morris6/Modulo-Two_ARINC-429_Converter/Mod2ArincBot.png

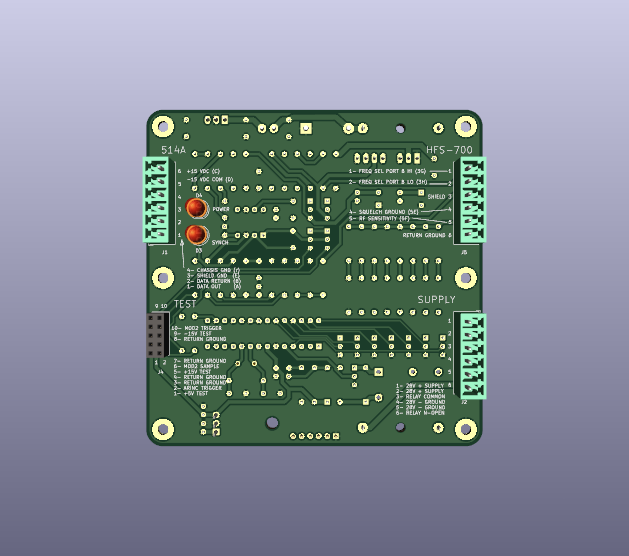
Mod2ArincBot.png
