morris6/Modulo-Two_ARINC-429_Converter/Mod2ArincTop.png

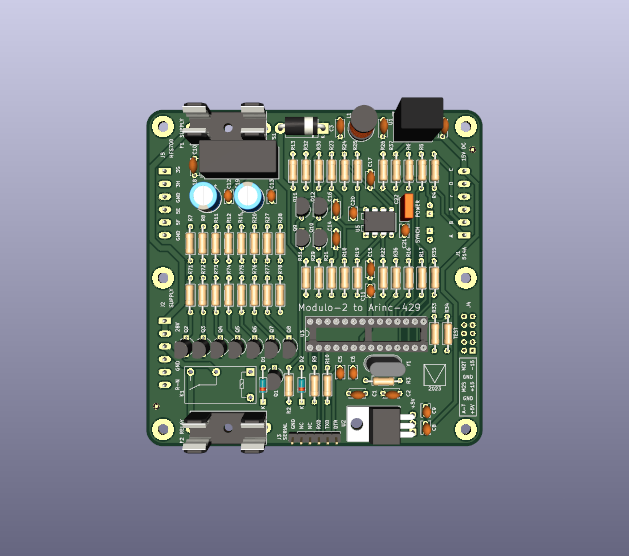
Mod2ArincTop.png
