morris6/Modulo-Two_ARINC-429_Converter/Mod2Boxed.png

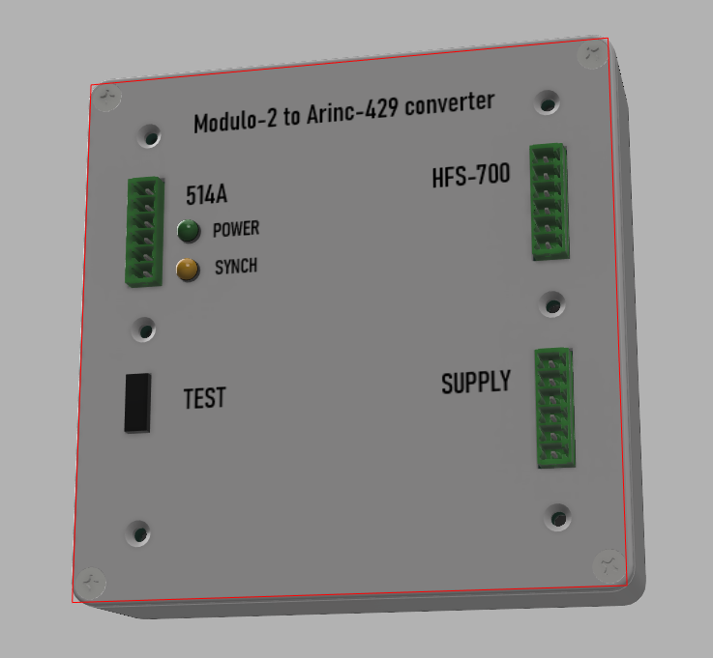
Mod2Boxed.png
