morris6/Modulo-Two_ARINC-429_Converter/(list of files, cad)

Other CAD files:
Mod2ArincProject/1590Q-U-V Lid.f3d
