morris6/Modulo-Two_ARINC-429_Converter/Mod2Arinc.pdf

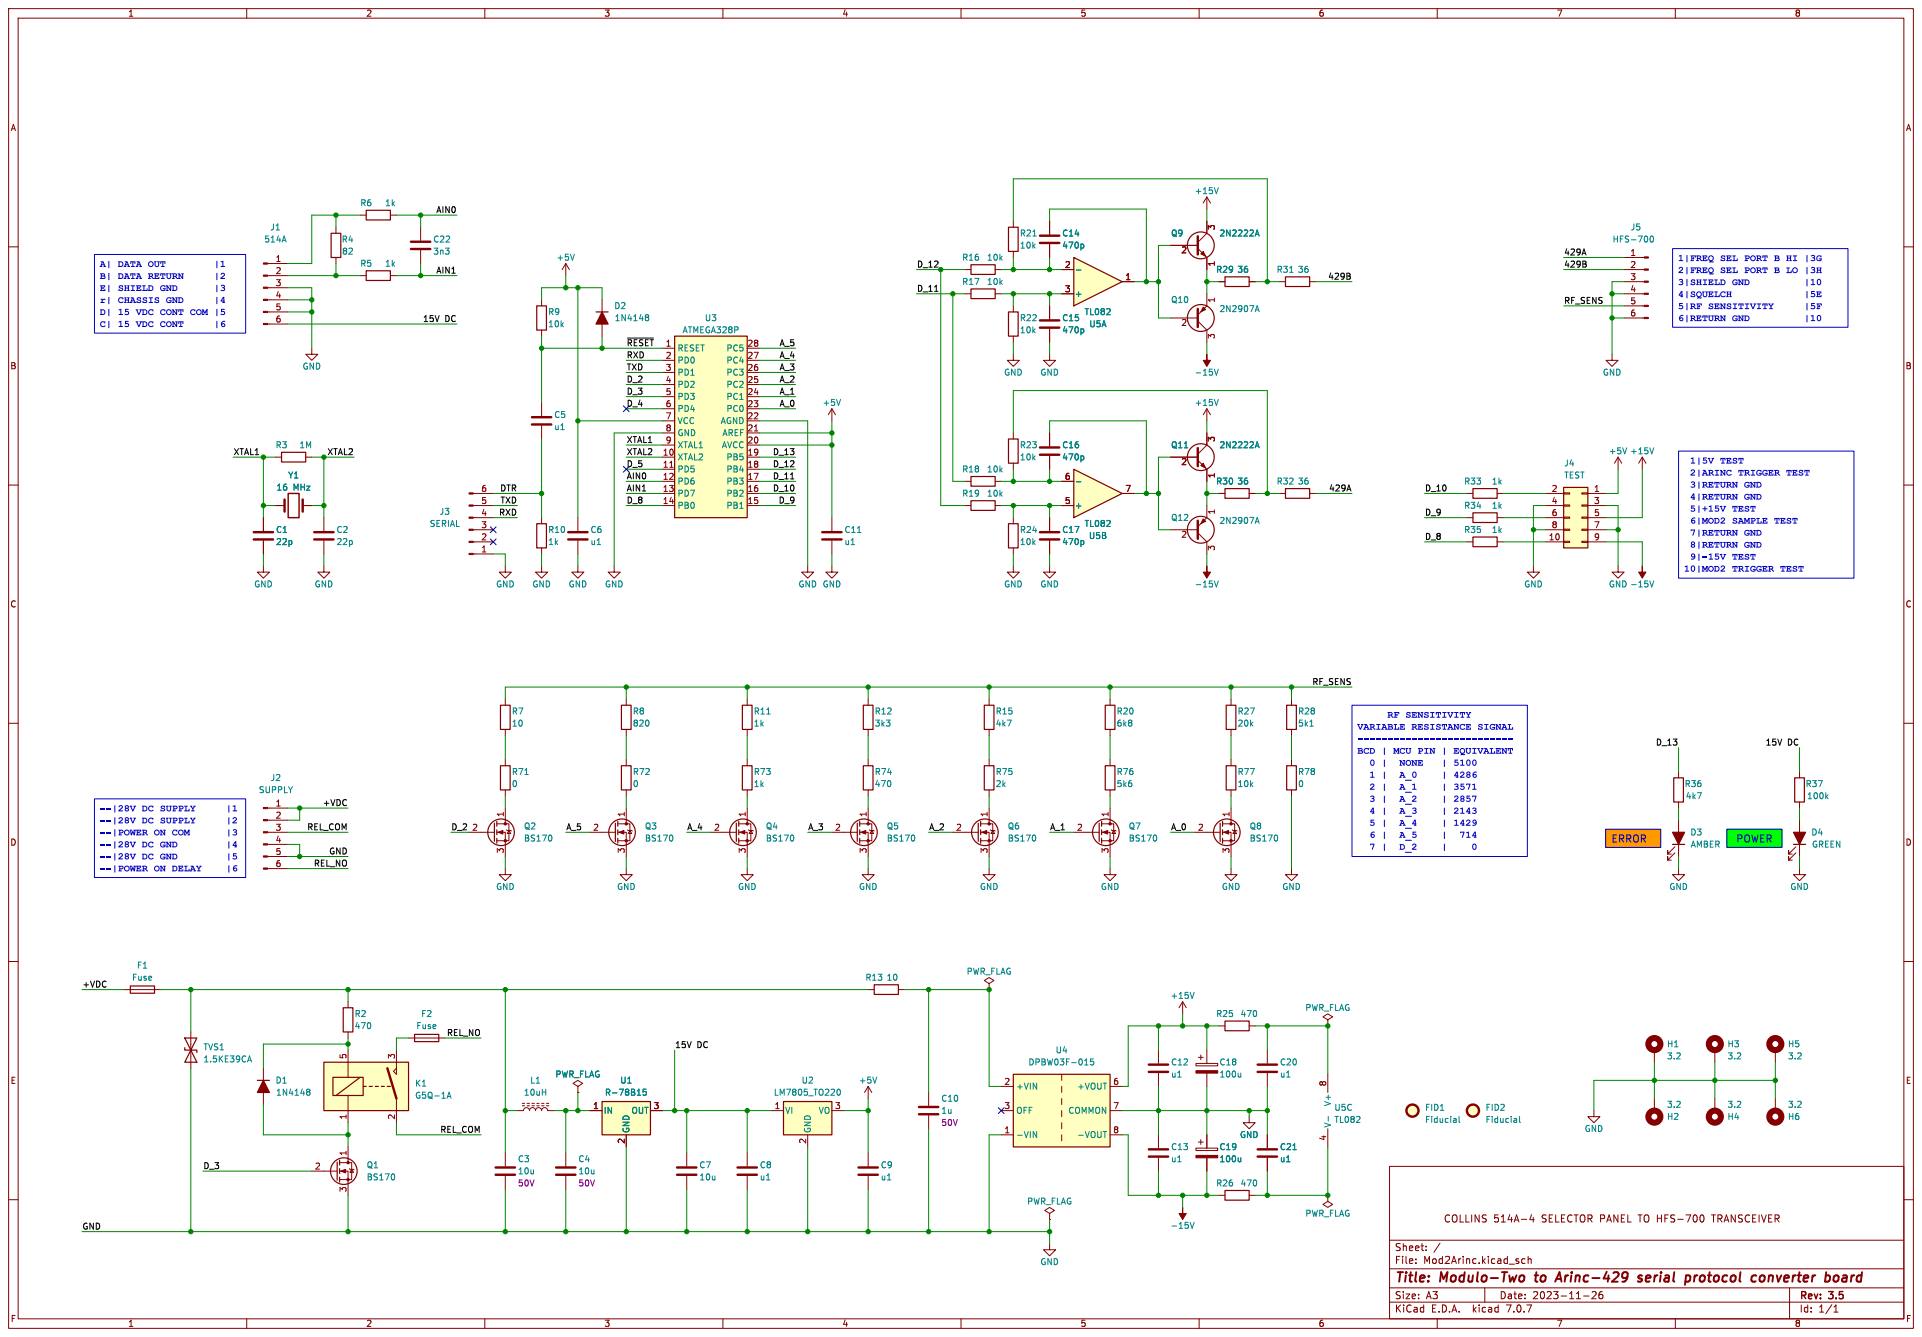
[picture p4: page 1]

1|FREQ SEL PORT B HI |3G
2|FREQ SEL PORT B LO |3H
