morris6/Modulo-Two_ARINC-429_Converter/Mod2ArincProject/Mod2Arinc.kicad_pcb

## KiCad design Mod2ArincProject/Mod2Arinc.kicad_pcb (2023-11-26)

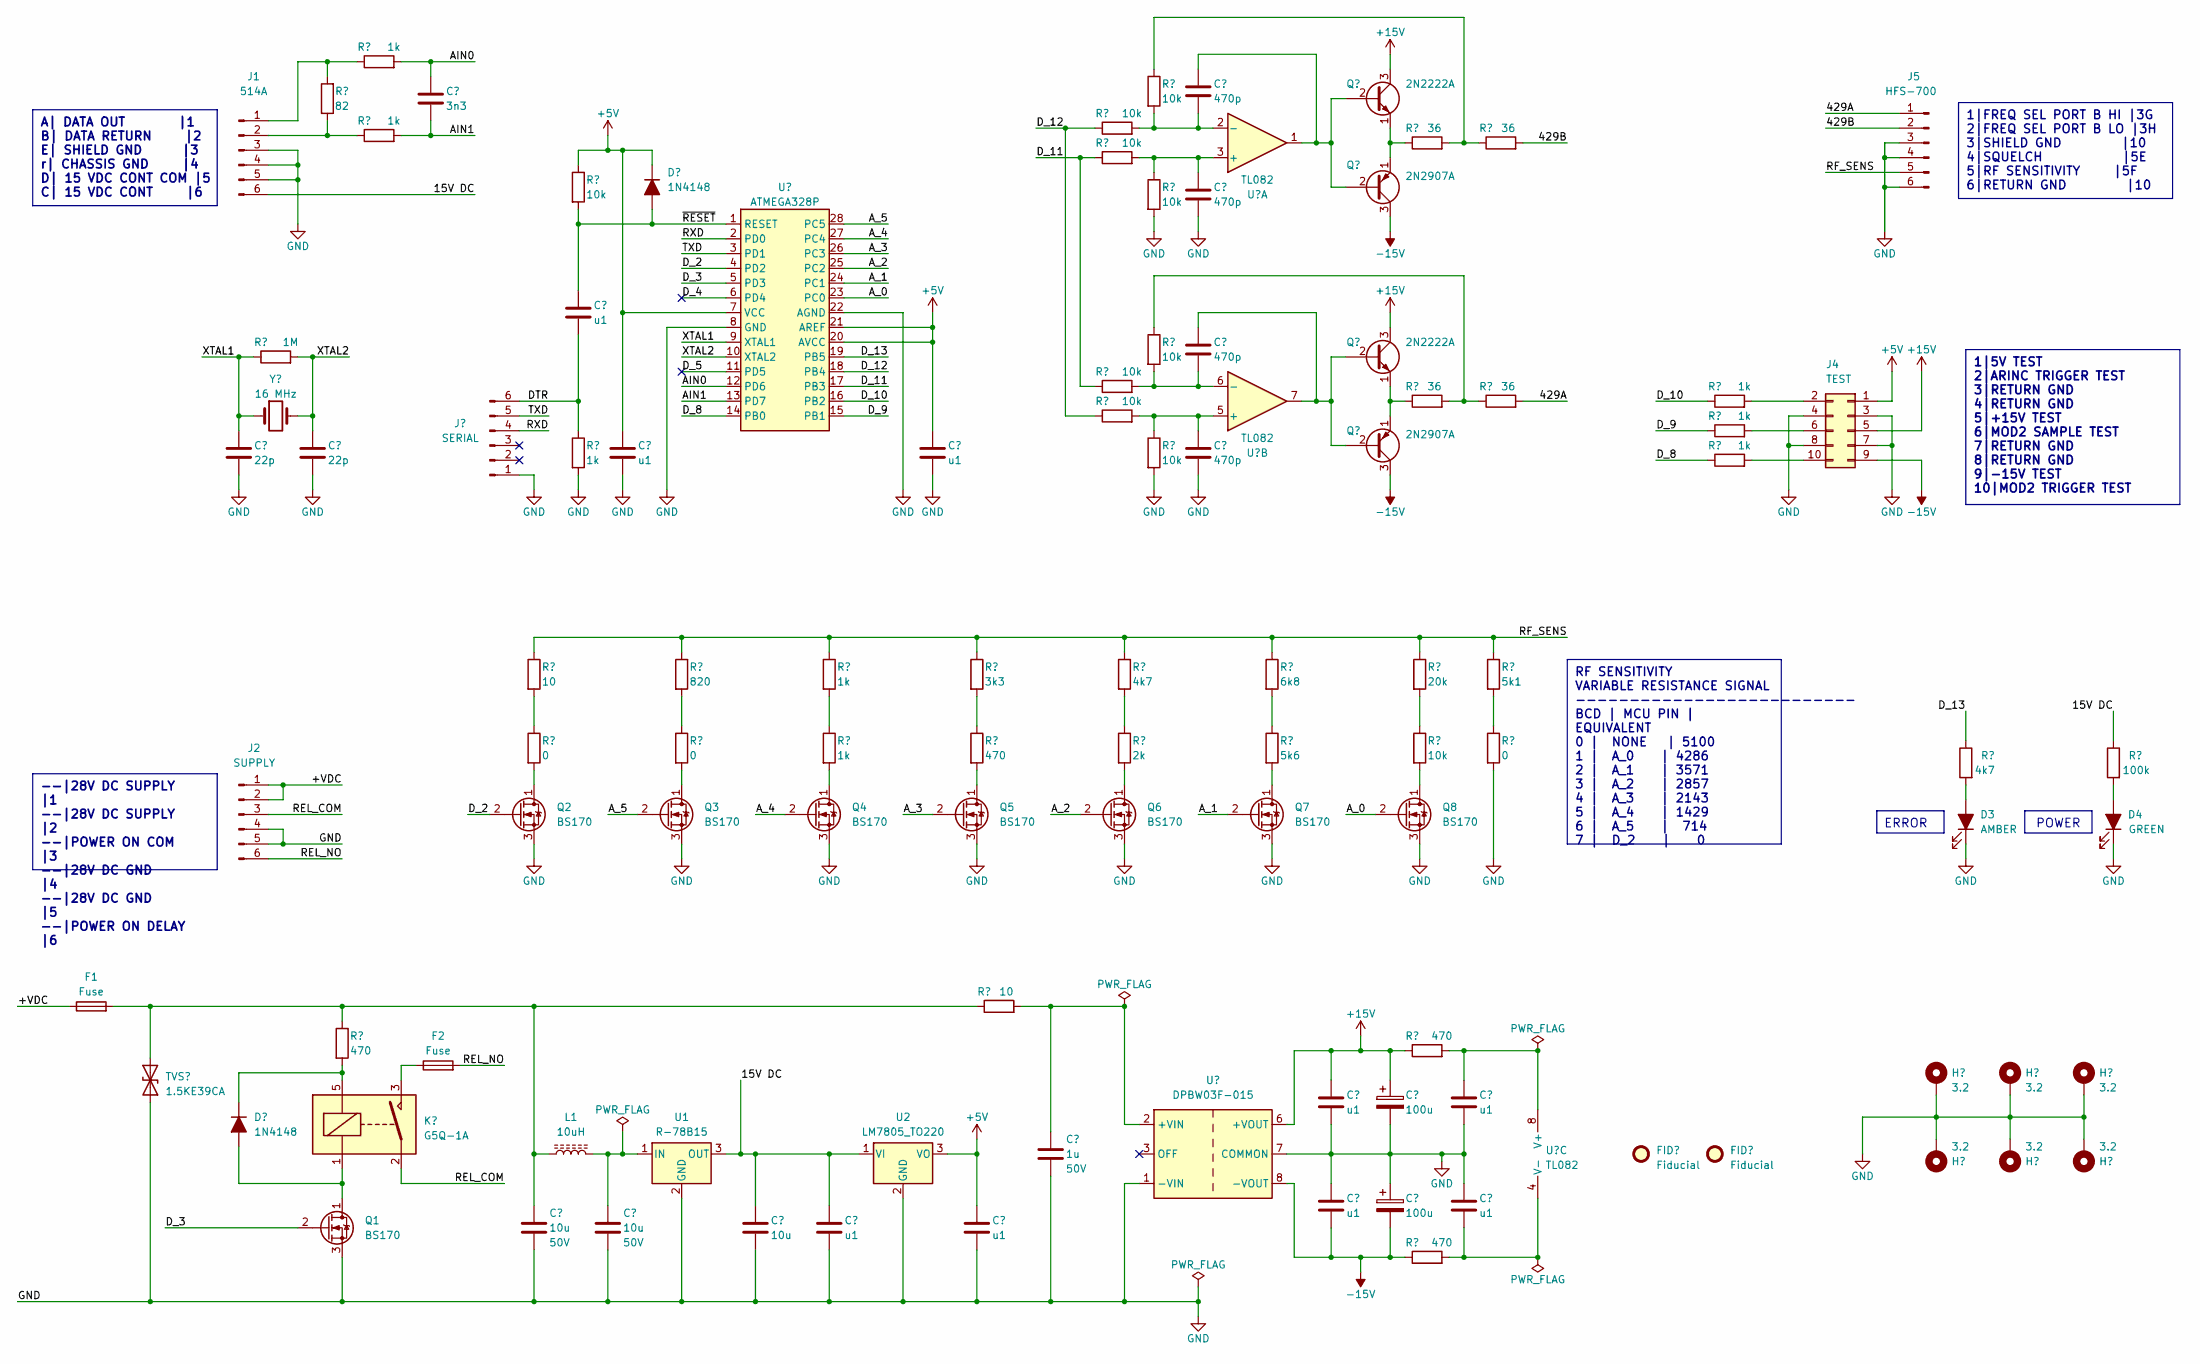
[picture p5: schematic Mod2Arinc.kicad_sch, Modulo-Two to Arinc-429 serial protocol converter board]

Parts:
C1, C2: 22p; C_Disc_D4.7mm_W2.5mm_P5.00mm
C3, C4, C7: 10u; C_Disc_D5.0mm_W2.5mm_P5.00mm
C5, C6, C8, C9, C11, C12, C13, C20, C21: u1; C_Disc_D3.8mm_W2.6mm_P2.50mm
C10: 1u; C_Disc_D5.0mm_W2.5mm_P5.00mm
C14, C15, C16, C17: 470p; C_Disc_D4.7mm_W2.5mm_P5.00mm
C18, C19: 100u; CP_Radial_D8.0mm_P3.80mm
C22: 3n3; C_Rect_L7.0mm_W2.5mm_P5.00mm
D1, D2: 1N4148; D_DO-35_SOD27_P10.16mm_Horizontal
D3: AMBER; LED_D5.0mm
D4: GREEN; LED_D5.0mm
F1, F2: Fuse; Fuseholder_Cylinder-5x20mm_Schurter_0031_8201_Horizontal_Op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
FID1, FID2: Fiducial; Fiducial_1mm_Mask2mm
H1, H2, H3, H4, H5, H6: 3.2; MountingHole_3.2mm_M3_Pad_TopBottom
J1: 514A; PhoenixContact_MCV_1,5_6-G-3.81_1x06_P3.81mm_Vertical
J2: SUPPLY; PhoenixContact_MCV_1,5_6-G-3.81_1x06_P3.81mm_Vertical
J3: SERIAL; PinHeader_1x06_P2.54mm_Vertical
J4: TEST; PinSocket_2x05_P2.54mm_Vertical
J5: HFS-700; PhoenixContact_MCV_1,5_6-G-3.81_1x06_P3.81mm_Vertical
K1: G5Q-1A; Relay_SPST_Omron-G5Q-1A
L1: 10uH; L_Radial_D7.5mm_P3.50mm_Fastron_07P
Q1, Q2, Q3, Q4, Q5, Q6, Q7, Q8: BS170; TO-92L_Inline_Wide
Q9, Q11: 2N2222A; TO-92L_Inline_Wide
Q10, Q12: 2N2907A; TO-92L_Inline_Wide
R2, R25, R26, R74: 470; R_Axial_DIN0207_L6.3mm_D2.5mm_P10.16mm_Horizontal
R3: 1M; R_Axial_DIN0207_L6.3mm_D2.5mm_P10.16mm_Horizontal
R4: 82; R_Axial_DIN0207_L6.3mm_D2.5mm_P10.16mm_Horizontal
R5, R6, R10, R11, R33, R34, R35, R73: 1k; R_Axial_DIN0207_L6.3mm_D2.5mm_P10.16mm_Horizontal
R7, R13: 10; R_Axial_DIN0207_L6.3mm_D2.5mm_P10.16mm_Horizontal
R8: 820; R_Axial_DIN0207_L6.3mm_D2.5mm_P10.16mm_Horizontal
R9, R16, R17, R18, R19, R21, R22, R23, R24, R77: 10k; R_Axial_DIN0207_L6.3mm_D2.5mm_P10.16mm_Horizontal
R12: 3k3; R_Axial_DIN0207_L6.3mm_D2.5mm_P10.16mm_Horizontal
R15, R36: 4k7; R_Axial_DIN0207_L6.3mm_D2.5mm_P10.16mm_Horizontal
R20: 6k8; R_Axial_DIN0207_L6.3mm_D2.5mm_P10.16mm_Horizontal
R27: 20k; R_Axial_DIN0207_L6.3mm_D2.5mm_P10.16mm_Horizontal
R28: 5k1; R_Axial_DIN0207_L6.3mm_D2.5mm_P10.16mm_Horizontal
R29, R30, R31, R32: 36; R_Axial_DIN0207_L6.3mm_D2.5mm_P10.16mm_Horizontal
R37: 100k; R_Axial_DIN0207_L6.3mm_D2.5mm_P10.16mm_Horizontal
R71, R72, R78: 0; R_Axial_DIN0207_L6.3mm_D2.5mm_P10.16mm_Horizontal
R75: 2k; R_Axial_DIN0207_L6.3mm_D2.5mm_P10.16mm_Horizontal
R76: 5k6; R_Axial_DIN0207_L6.3mm_D2.5mm_P10.16mm_Horizontal
TVS1: 1.5KE39CA; D_DO-201AD_P12.70mm_Horizontal
U1: R-78B15; Converter_DCDC_RECOM_R-78B-2.0_THT
U2: LM7805_TO220; TO-220-3_Horizontal_TabDown
U3: ATMEGA328P; DIP-28_W7.62mm_Socket
U4: DPBW03F-015; Converter_DCDC_TRACO_TMR-xxxx_THT
U5: TL082; DIP-8_W7.62mm
Y1: 16 MHz; Crystal_HC18-U_Vertical

Connections:
+5V: C6.1, C9.1, C11.1, D2.1 (K), J4.1, R9.1, U2.3 (VO), U3.7 (VCC), U3.20 (AVCC), U3.21 (AREF)
+15V: C12.1, C18.1, J4.5, Q9.3 (C), Q11.3 (C), R25.1, U4.6 (+VOUT)
-15V: C13.2, C19.2, J4.9, Q10.3 (C), Q12.3 (C), R26.1, U4.8 (-VOUT)
/15V DC: C7.1, C8.1, J1.6, R37.1, U1.3 (OUT), U2.1 (VI)
/429A: J5.1, R32.2
/429B: J5.2, R31.2
/+VDC: F1.1, J2.1, J2.2
/AIN0: C22.1, R6.2, U3.12 (PD6)
/AIN1: C22.2, R5.2, U3.13 (PD7)
/A_0: Q8.2 (G), U3.23 (PC0)
/A_1: Q7.2 (G), U3.24 (PC1)
/A_2: Q6.2 (G), U3.25 (PC2)
/A_3: Q5.2 (G), U3.26 (PC3)
/A_4: Q4.2 (G), U3.27 (PC4)
/A_5: Q3.2 (G), U3.28 (PC5)
/DTR: C5.2, J3.6, R10.1
/D_2: Q2.2 (G), U3.4 (PD2)
/D_3: Q1.2 (G), U3.5 (PD3)
/D_4: U3.6 (PD4)
/D_5: U3.11 (PD5)
/D_8: R35.1, U3.14 (PB0)
/D_9: R34.1, U3.15 (PB1)
/D_10: R33.1, U3.16 (PB2)
/D_11: R17.1, R18.1, U3.17 (PB3)
/D_12: R16.1, R19.1, U3.18 (PB4)
/D_13: R36.1, U3.19 (PB5)
/REL_COM: J2.3, K1.2
/REL_NO: F2.2, J2.6
/RF_SENS: J5.5, R7.1, R8.1, R11.1, R12.1, R15.1, R20.1, R27.1, R28.1
/RXD: J3.4, U3.2 (PD0)
/TXD: J3.5, U3.3 (PD1)
/XTAL1: C1.1, R3.1, U3.9 (XTAL1), Y1.1
/XTAL2: C2.1, R3.2, U3.10 (XTAL2), Y1.2
/~RESET: C5.1, D2.2 (A), R9.2, U3.1 (RESET)
GND: C1.2, C2.2, C3.2, C4.2, C6.2, C7.2, C8.2, C9.2, C10.2, C11.2, C12.2, C13.1, C15.2, C17.2, C18.2, C19.1, C20.2, C21.1, D3.1 (K), D4.1 (K), H1.1, H2.1, H3.1, H4.1, H5.1, H6.1, J1.3, J1.4, J1.5, J2.4, J2.5, J3.1, J4.3, J4.4, J4.7, J4.8, J5.3, J5.4, J5.6, Q1.3 (S), Q2.3 (S), Q3.3 (S), Q4.3 (S), Q5.3 (S), Q6.3 (S), Q7.3 (S), Q8.3 (S), R10.2, R22.2, R24.2, R78.2, TVS1.1 (A1), U1.2 (GND), U2.2 (GND), U3.8 (GND), U3.22 (AGND), U4.1 (-VIN), U4.7 (COMMON)
unnamed: D1.2 (A), K1.1, Q1.1 (D)
unnamed: D1.1 (K), K1.5, R2.2
unnamed: D3.2 (A), R36.2
unnamed: D4.2 (A), R37.2
unnamed: F2.1, K1.3
unnamed: J1.1, R4.2, R6.1
unnamed: J1.2, R4.1, R5.1
unnamed: J4.2, R33.2
unnamed: J4.6, R34.2
unnamed: J4.10, R35.2
unnamed: Q2.1 (D), R71.2
unnamed: Q3.1 (D), R72.2
unnamed: Q4.1 (D), R73.2
unnamed: Q5.1 (D), R74.2
unnamed: Q6.1 (D), R75.2
unnamed: Q7.1 (D), R76.2
unnamed: Q8.1 (D), R77.2
unnamed: C14.1, Q9.2 (B), Q10.2 (B), U5.1
unnamed: Q9.1 (E), Q10.1 (E), R29.1
unnamed: C16.1, Q11.2 (B), Q12.2 (B), U5.7
unnamed: Q11.1 (E), Q12.1 (E), R30.1
unnamed: R7.2, R71.1
unnamed: R11.2, R73.1
unnamed: R12.2, R74.1
unnamed: R15.2, R75.1
unnamed: R20.2, R76.1
unnamed: R21.1, R29.2, R31.1
unnamed: R23.1, R30.2, R32.1
unnamed: R27.2, R77.1
unnamed: R28.2, R78.1
unnamed: R8.2, R72.1
unnamed: C3.1, F1.2, L1.1, R2.1, R13.1, TVS1.2 (A2)
unnamed: C4.1, L1.2, U1.1 (IN)
unnamed: C10.1, R13.2, U4.2 (+VIN)
unnamed: C15.1, R17.2, R22.1, U5.3 (+)
unnamed: C14.2, R16.2, R21.2, U5.2 (-)
unnamed: C17.1, R19.2, R24.1, U5.5 (+)
unnamed: C16.2, R18.2, R23.2, U5.6 (-)
unnamed: C20.1, R25.2, U5.8 (V+)
unnamed: C21.2, R26.2, U5.4 (V-)

Notes on the sheet:
1|FREQ SEL PORT B HI |3G 2|FREQ SEL PORT B LO |3H 3|SHIELD GND |10 4|SQUELCH |5E 5|RF SENSITIVITY |5F 6|RETURN GND |10
1|5V TEST 2|ARINC TRIGGER TEST 3|RETURN GND 4|RETURN GND 5|+15V TEST 6|MOD2 SAMPLE TEST 7|RETURN GND 8|RETURN GND 9|-15V TEST 10|MOD2 TRIGGER TEST
A| DATA OUT |1 B| DATA RETURN |2 E| SHIELD GND |3 r| CHASSIS GND |4 D| 15 VDC CONT COM |5 C| 15 VDC CONT |6
ERROR
POWER
RF SENSITIVITY VARIABLE RESISTANCE SIGNAL -------------------------- BCD | MCU PIN | EQUIVALENT 0 | NONE | 5100 1 | A_0 | 4286 2 | A_1 | 3571 3 | A_2 | 2857 4 | A_3 | 2143 5 | A_4 | 1429 6 | A_5 | 714 7 | D_2 | 0
--|28V DC SUPPLY |1 --|28V DC SUPPLY |2 --|POWER ON COM |3 --|28V DC GND |4 --|28V DC GND |5 --|POWER ON DELAY |6

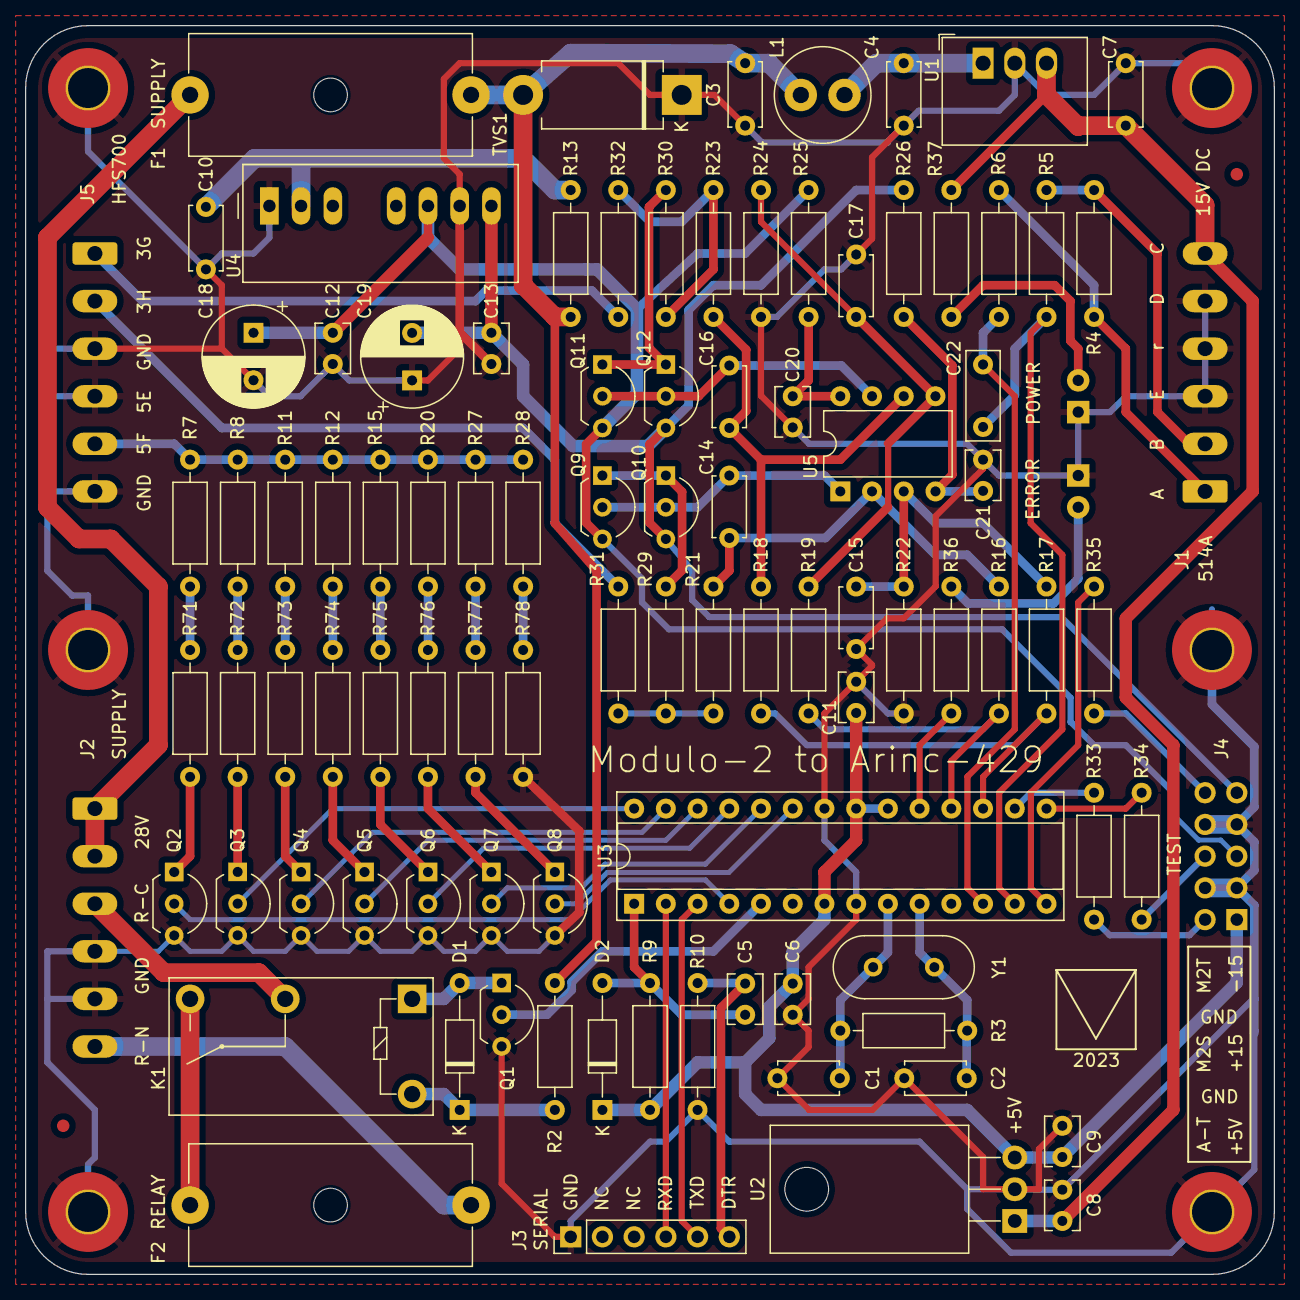
[picture p6: board Mod2Arinc.kicad_pcb from above]

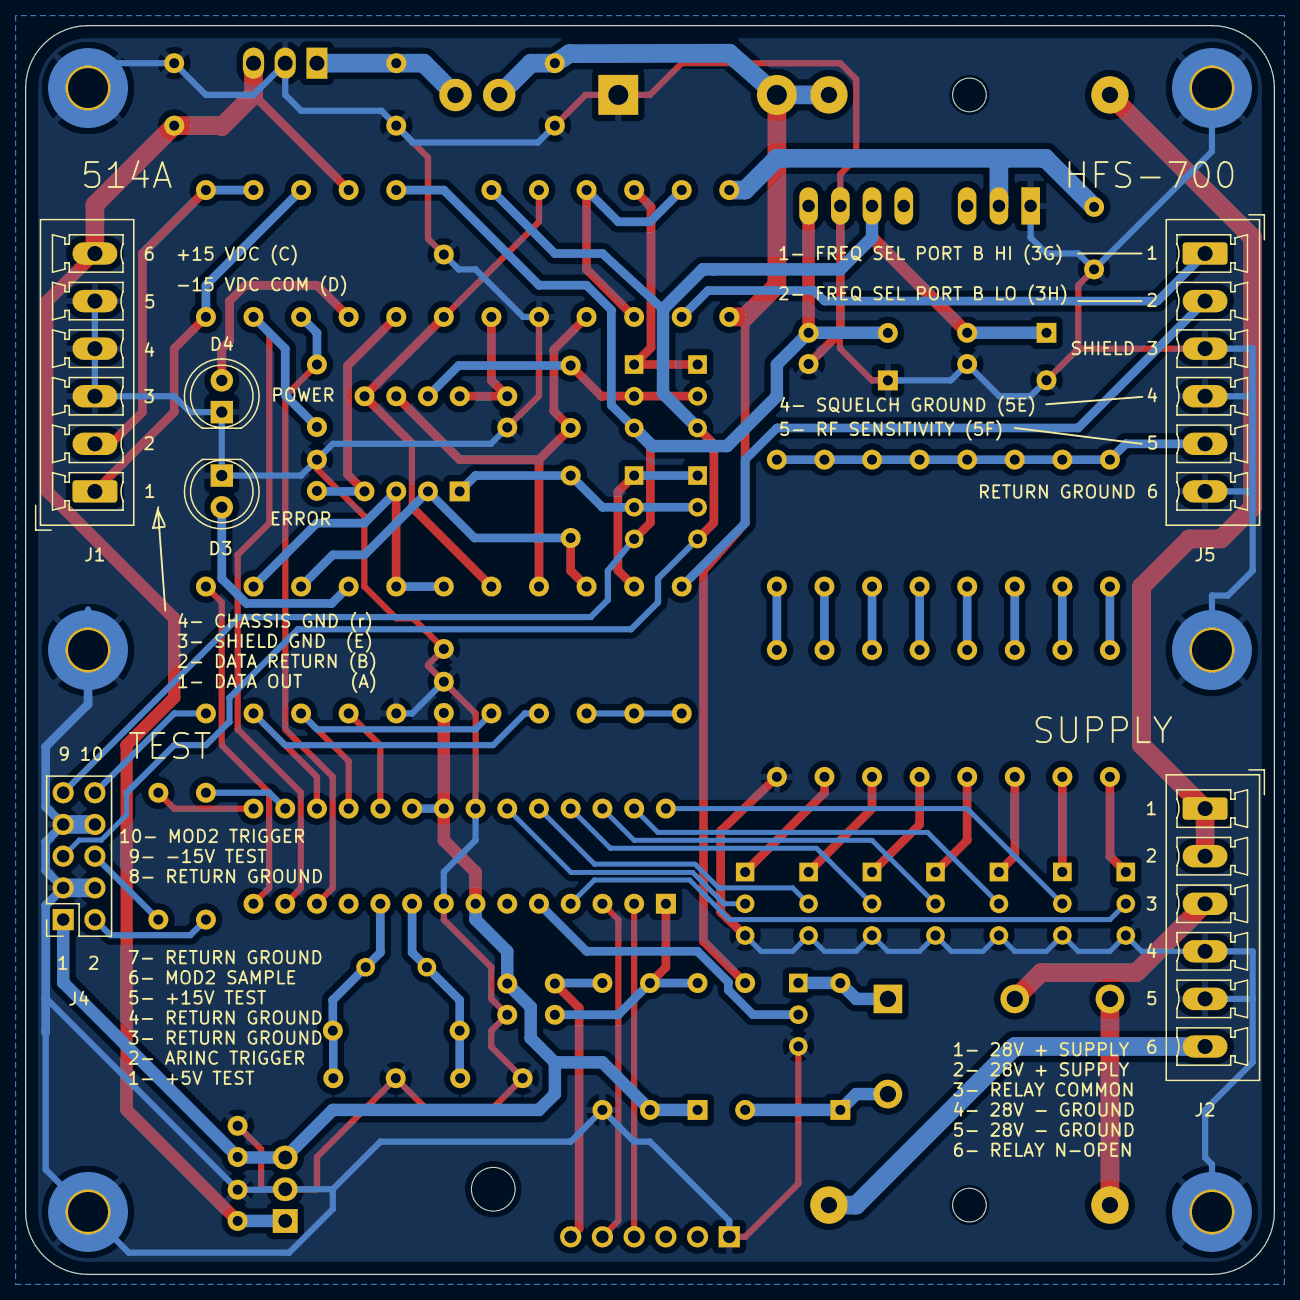
[picture p7: board Mod2Arinc.kicad_pcb from below]

Board: 2 copper layers, 100.0 x 100.0 mm, 105 parts (6 on the bottom side), 73 nets.
